MiroslawDebiec/QuadrupedRobot/README.md

# QuadrupedRobot
University Final Year Project - Quadruped Robotic Platform based around ESP32 microcontroller - Fusion360 / EasyEDA /  Arduino / C++ / Bootstrap / HTML / AJAX / CSS
